SnowHeight/-Controller/(commit log)

2018-02-26 genaeral now config
    General now Config
    [configuration.h]
2018-03-23 Condifguration change
    [configuration.h]
